austin-robots/SDg21/website/images/ab.png

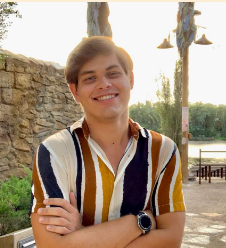
website/images/ab.png
