austin-robots/SDg21/website/images/ad.png

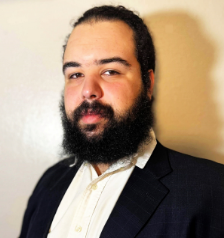
website/images/ad.png
