austin-robots/SDg21/README.md

# SDg21
Senior Design G21 SpringSummer 2025
