austin-robots/SDg21/website/images/mg.png

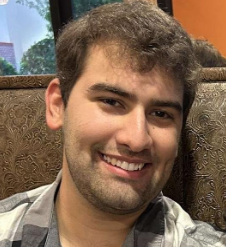
website/images/mg.png
