austin-robots/SDg21/website/images/tt.png

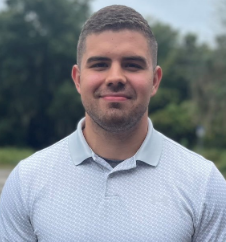
website/images/tt.png
